Menson2222/MSLora_Tramgiamsat/z6448733048042_e249e12e03f700655863f0466cb97d95.jpg

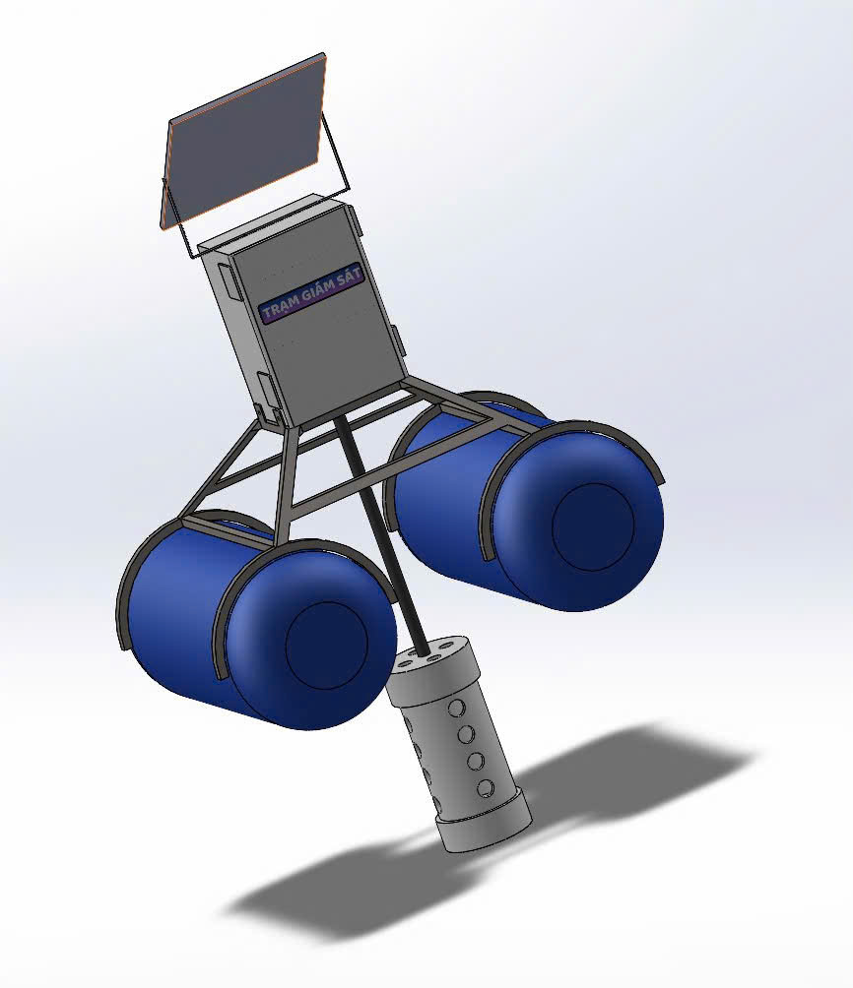
z6448733048042_e249e12e03f700655863f0466cb97d95.jpg
