Menson2222/MSLora_Tramgiamsat/z6448733080612_66e80a465675823b197837a850d44ab3.jpg

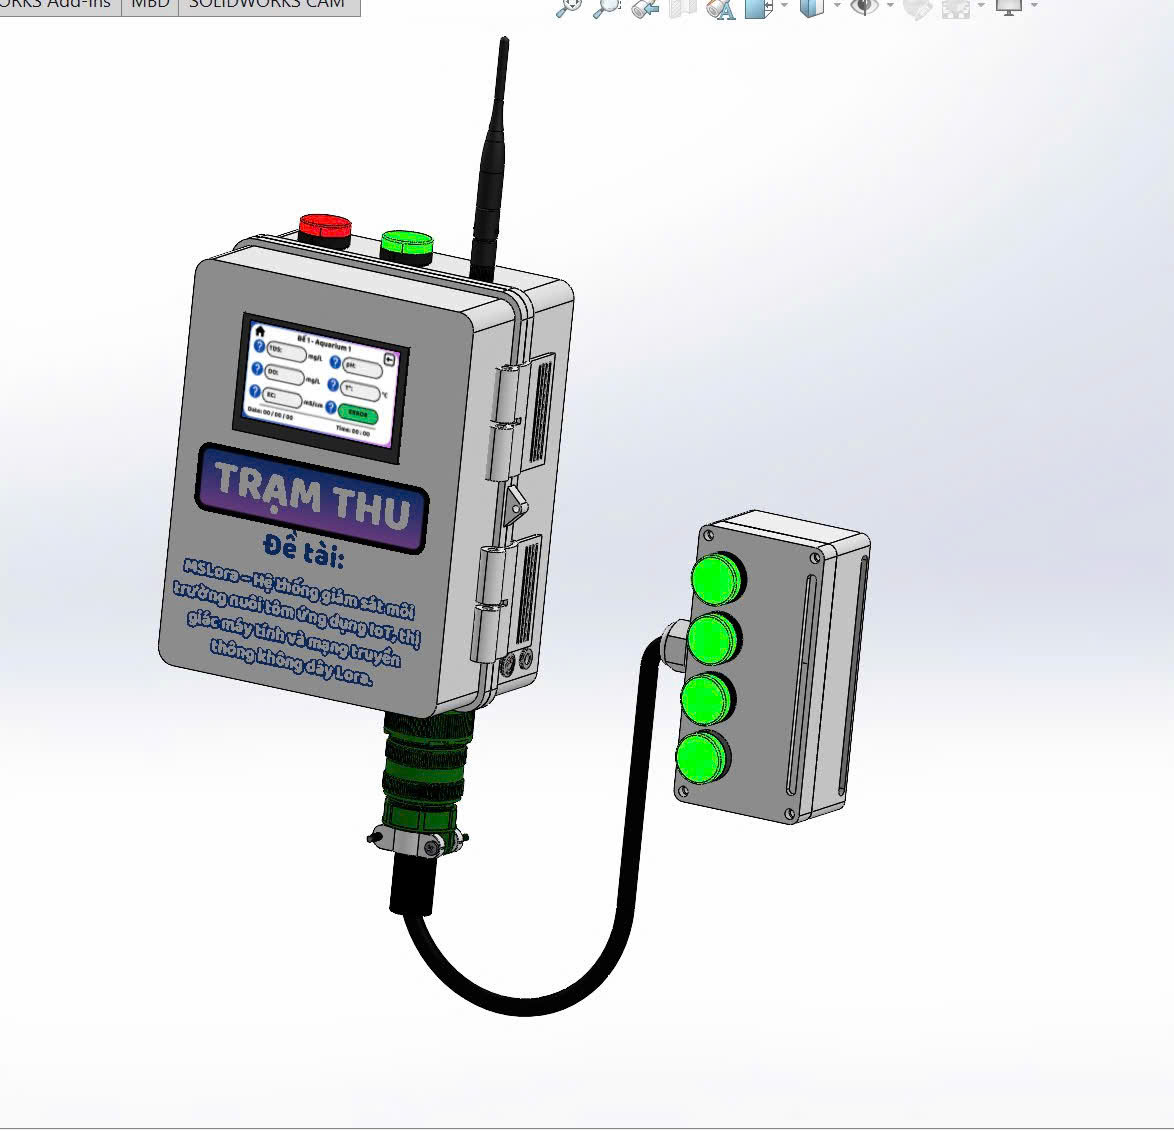
z6448733080612_66e80a465675823b197837a850d44ab3.jpg
