Menson2222/MSLora_Tramgiamsat/z6448733090743_e237ffbbd991f8c886ba38a65cebea2f.jpg

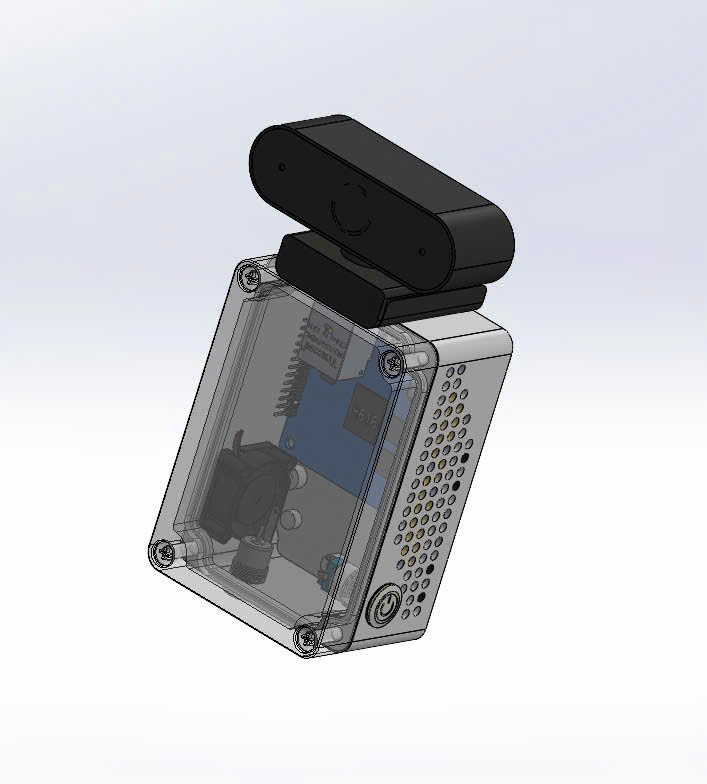
z6448733090743_e237ffbbd991f8c886ba38a65cebea2f.jpg
